MicrowavedCat/LoRaDrone/images/gantt_final.png

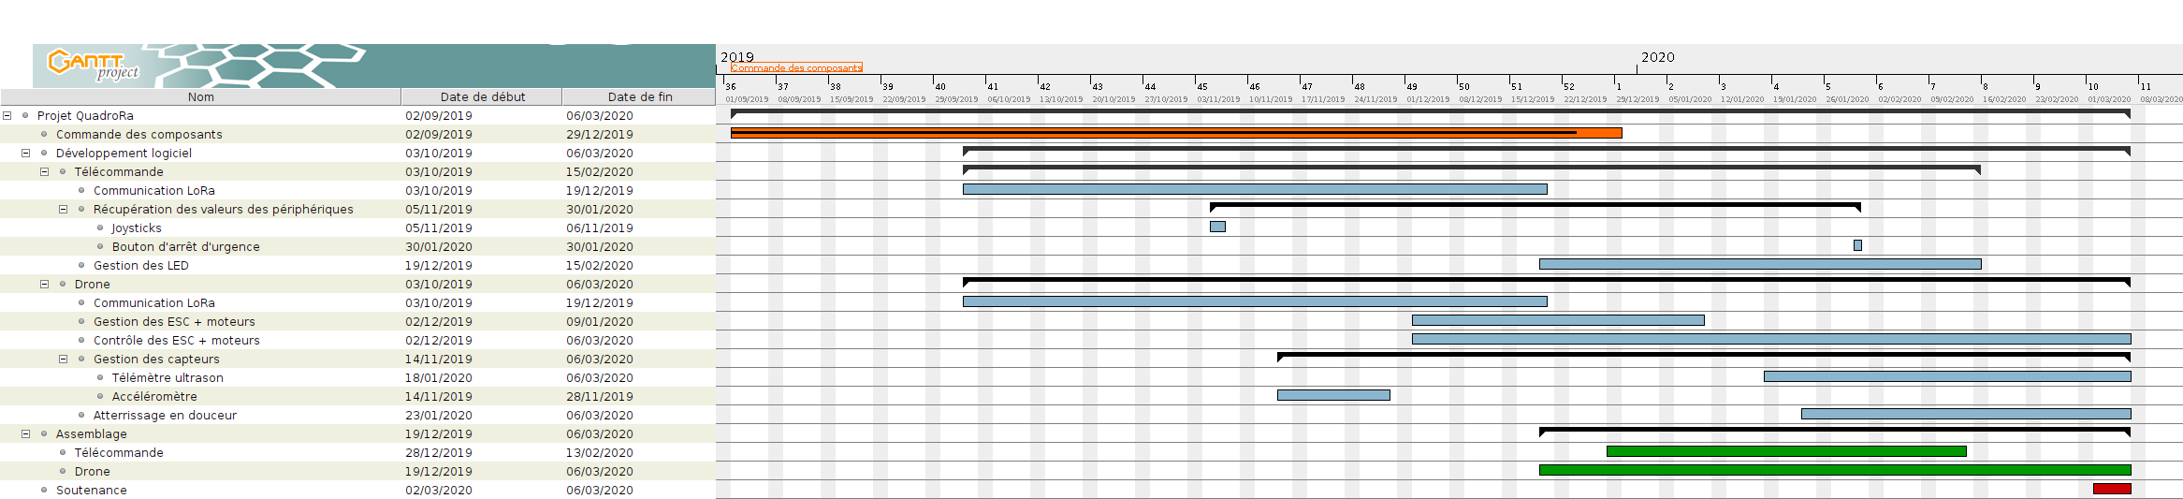
images/gantt_final.png
