MicrowavedCat/LoRaDrone/(commit log)

2019-11-14 Ajout de la v1.0 du cahier des charges
2020-01-20 Ajout des programmes de l'ESP32
2020-01-29 Mise à jour du code de la télécommande
